wdc3iii/Pomdot/Reports/Pomdot_Poster_Expo.pdf

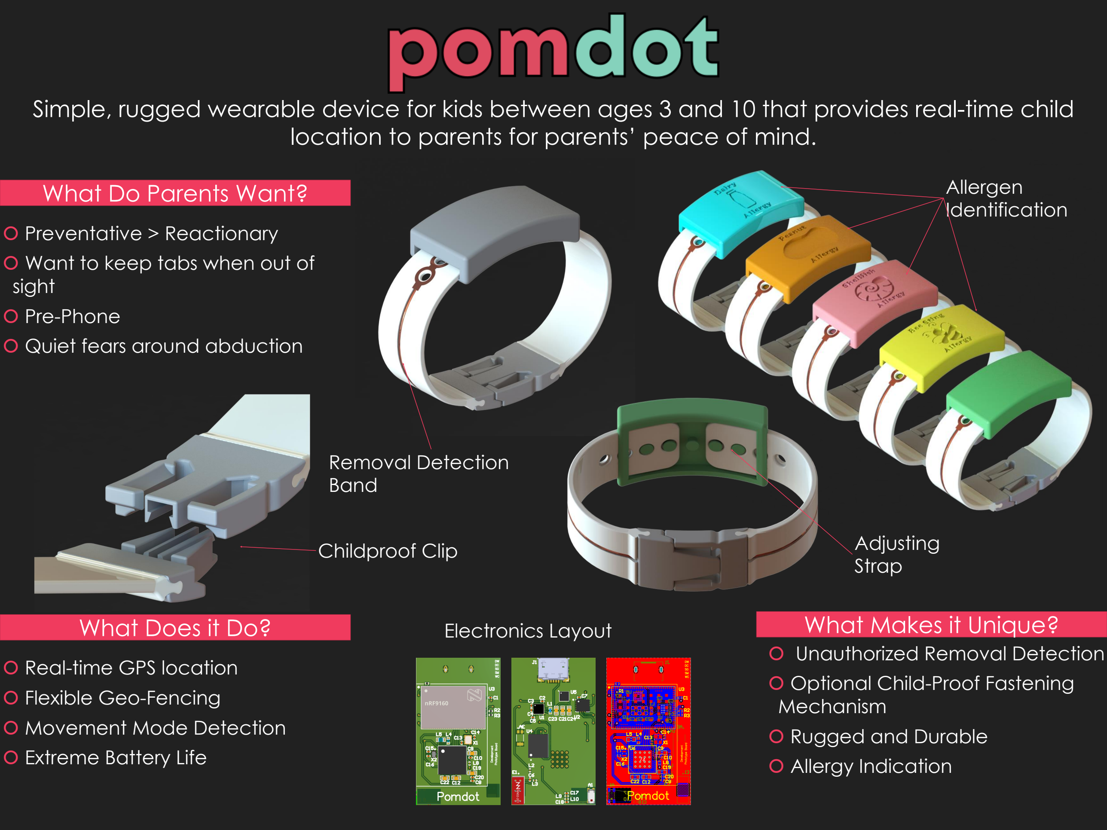
[picture p1: page 1]

Simple, rugged wearable device for kids between ages 3 and 10 that provides real-time child location to parents for parents’ peace of mind.

### What Do Parents Want?

- Preventative > Reactionary
- Want to keep tabs when out of sight
- Pre-Phone
- Quiet fears around abduction

### What Does it Do?

- Real-time GPS location
- Flexible Geo-Fencing
- Movement Mode Detection
- Extreme Battery Life

### What Makes it Unique?

- Unauthorized Removal Detection
- Optional Child-Proof Fastening Mechanism
- Rugged and Durable
- Allergy Indication

Childproof Clip

Allergen
Identification

Adjusting
Strap

Removal Detection
Band

Electronics Layout

Simple, rugged wearable device for kids between ages 3 and 10 that provides real-time child location to parents for parents’ peace of mind.

What Do Parents Want?

- Preventative >
Reactionary
- Want to keep tabs when
out of sight
- Pre-Phone
- Quiet fears around
abduction

What Does it Do?

- Real-time GPS location
- Flexible Geo-Fencing
- Movement Mode
Detection
- Extreme Battery Life

What Makes it Unique?

- Unauthorized Removal
Detection
- Optional Child-Proof
Fastening Mechanism
- Rugged and Durable
- Allergy Indication

Childproof
Clip

Allergen
Identification

Adjusting
Strap

Removal Detection
Band

Electronics Layout

### BLE Range: 400 feet

### Cellular Range: Global

### GPS Resolution: ~1m

### Battery Life: 175 hours

Outdoor
Range
(Line of
Sight)

260’

150’

Competitor’s

Ours
Specification

App Layout

400’

Indoor

(Wall
Penetration
– Industrial)

6 Walls

Indoor

(Multi-Floor–
Industrial)

3 Floors

7 Walls 4 Floors

Simple, rugged wearable device for kids between ages 3 and 10 that provides real-time child location to parents for parents’ peace of mind.

What Do Parents Want?

- Preventative >
Reactionary
- Want to keep tabs when
out of sight
- Pre-Phone
- Quiet fears around
abduction

What Does it Do?

- Real-time GPS location
- Flexible Geo-Fencing
- Movement Mode
Detection
- Extreme Battery Life

What Makes it Unique?

- Unauthorized Removal
Detection
- Optional Child-Proof
Fastening Mechanism
- Rugged and Durable
- Allergy Indication

Childproof
Clip

Allergen
Identification

Adjusting
Strap

Removal Detection
Band

Electronics Layout

### BLE Range: 400 feet

### Cellular Range: Global

### GPS Resolution: ~1m

### Battery Life: 175 hours

Outdoor

260’

150’

Competitor’s

Ours
Specification

App Layout

400’

Indoor

6 Walls

Indoor

3 Floors

7 Walls 4 Floors

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

What Do Parents Want?

- Preventative >
Reactionary
- Want to keep tabs when
out of sight
- Pre-Phone Monitoring
- Quiet fears around
abduction

What Does it Do?

- Real-time GPS location
- Flexible Geo-Fencing
- Movement Mode
Detection
- Extreme Battery Life

What Makes it Unique?

- Unauthorized Removal
Detection
- Optional Child-Proof
Fastening Mechanism
- Rugged and Durable
- Allergy Indication

Childproof
Clip

Allergen
Identification

Adjusting
Strap

Removal Detection
Band

Electronics Layout

### BLE Range: 400 feet

### Cellular Range: Global

### GPS Resolution: ~1m

### Battery Life: 175 hours

Outdoor

260’

150’

Competitor’s

Ours
Specification

App Layout

400’

Indoor

6 Walls

Indoor

3 Floors

7 Walls 4 Floors
