wdc3iii/Pomdot/Reports/Presentation 3.pdf

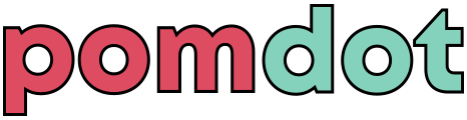
[picture p12: figure]

## What is it?

### Simple, rugged wearable device for kids between ages 3 and 10 that provides real-time child location to parents for parents’ peace of mind

## What Do Parents Want?

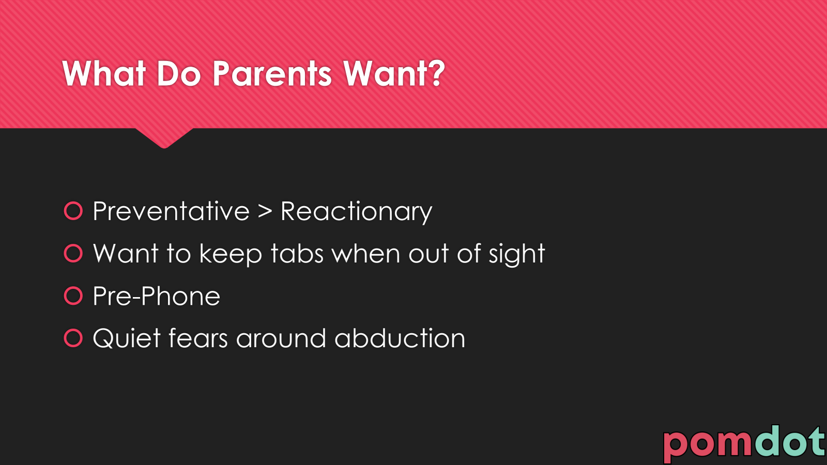
[picture p13: page 3]

- Preventative > Reactionary
- Want to keep tabs when out of sight
- Pre-Phone
- Quiet fears around abduction

## What does it do?

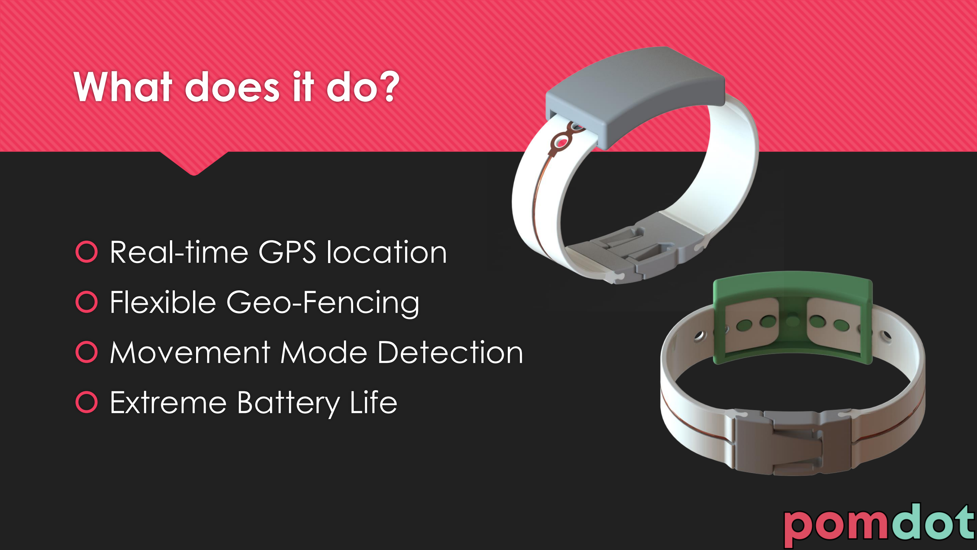
[picture p14: page 4]

- Real-time GPS location
- Flexible Geo-Fencing
- Movement Mode Detection
- Extreme Battery Life

## What makes it unique?

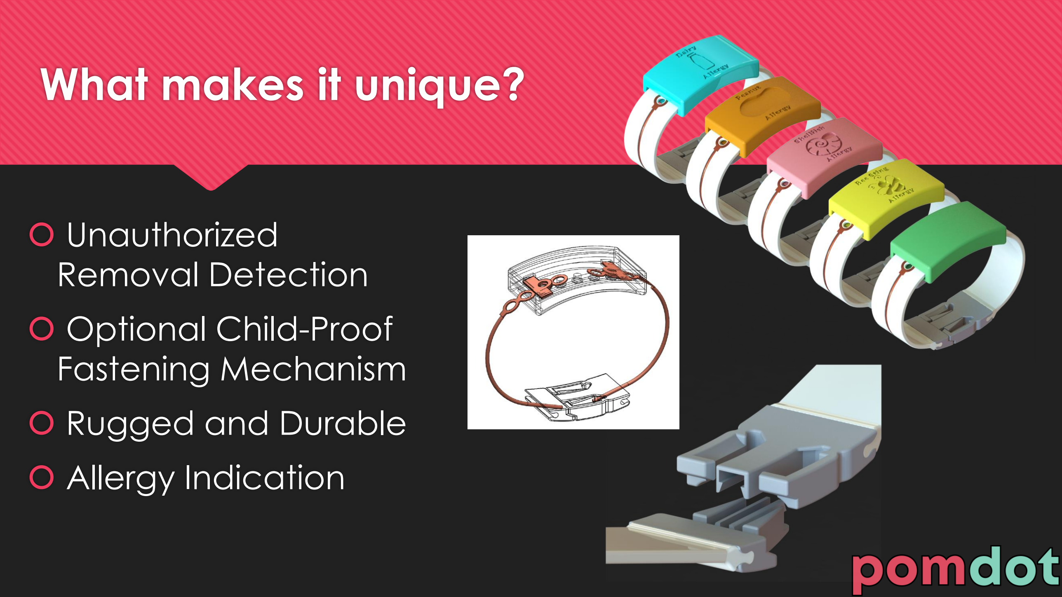
[picture p15: page 5]

- Unauthorized
Removal Detection
- Optional Child-Proof
Fastening Mechanism
- Rugged and Durable
- Allergy Indication

## Demo Time!

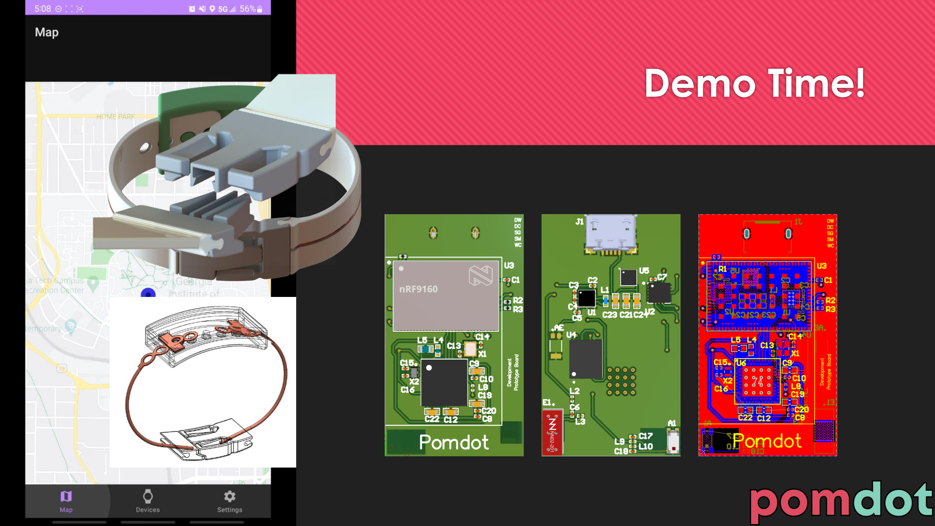
[picture p16: page 6]

## QUESTIONS?

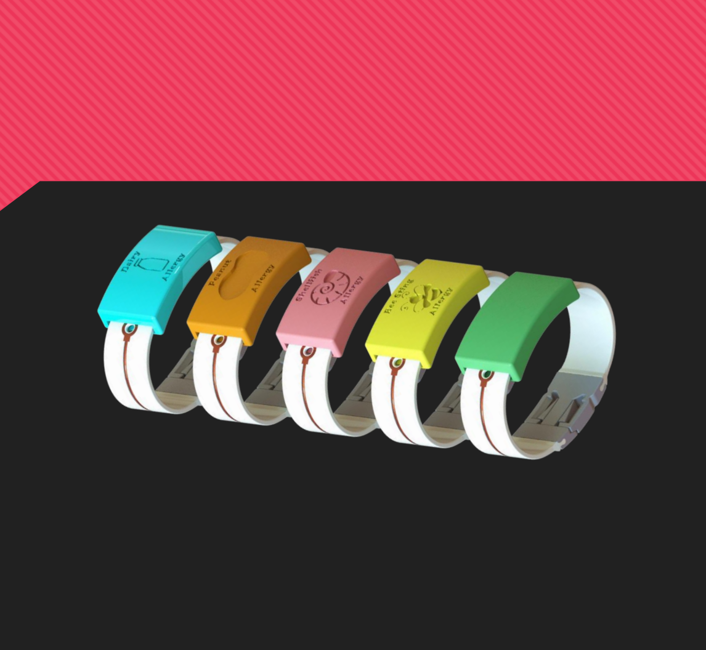
[picture p17: figure]
