wdc3iii/Pomdot/Reports/Presentation2.pdf

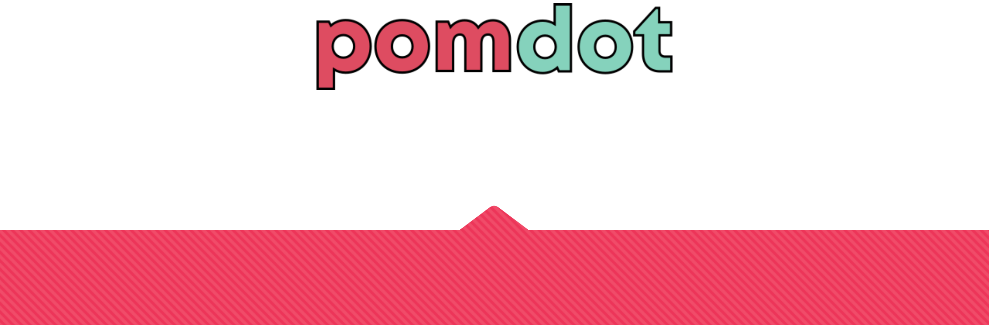
[picture p18: figure]

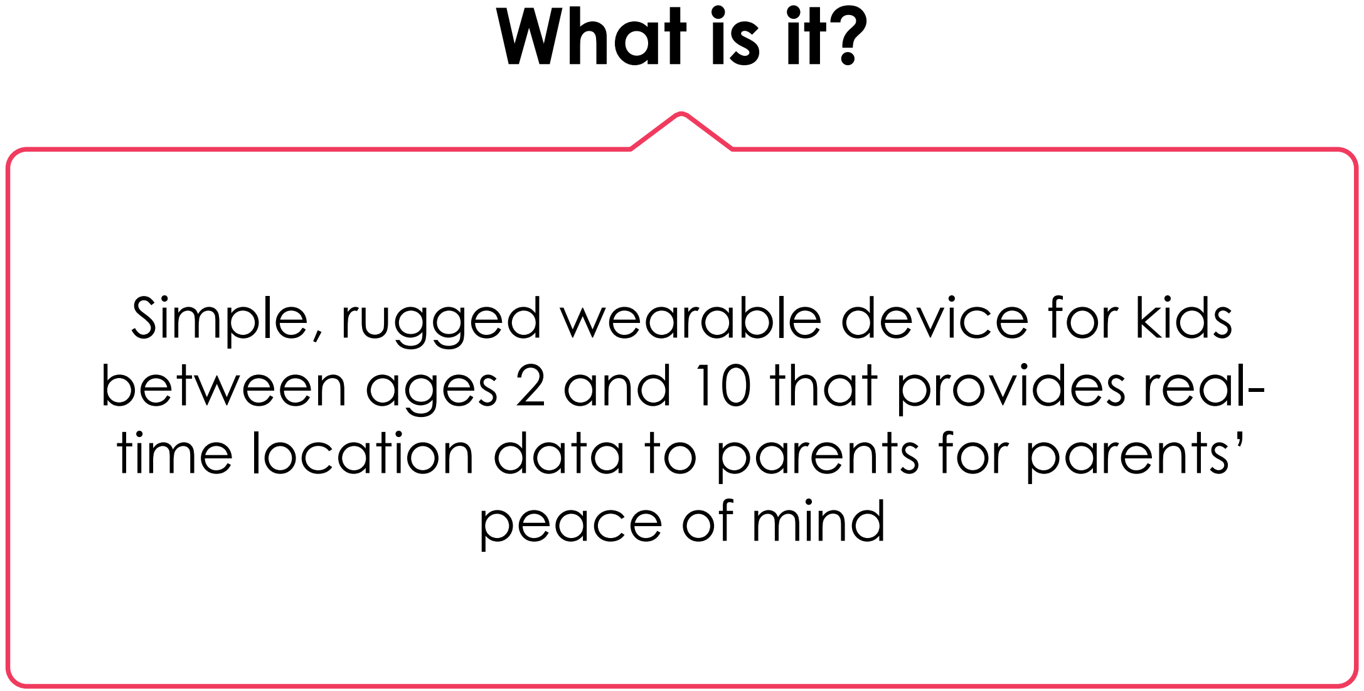
[picture p19: figure]
What is it?; Simple, rugged wearable device for kids; peace of mind

# between ages 2 and 10 that provides realtime location data to parents for parents’

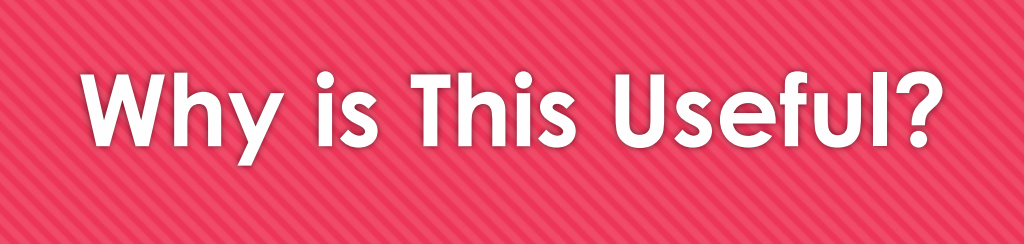
[picture p20: figure]
Why is This Useful?
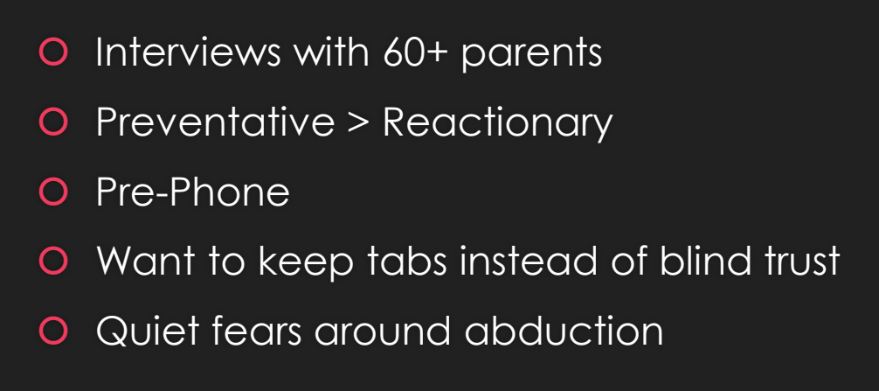
[picture p21: figure]
Interviews with 60+ parents; Preventative > Reactionary; Pre-Phone; Quiet fears around abduction

- Want to keep tabs instead of blind trust

# Existing Products

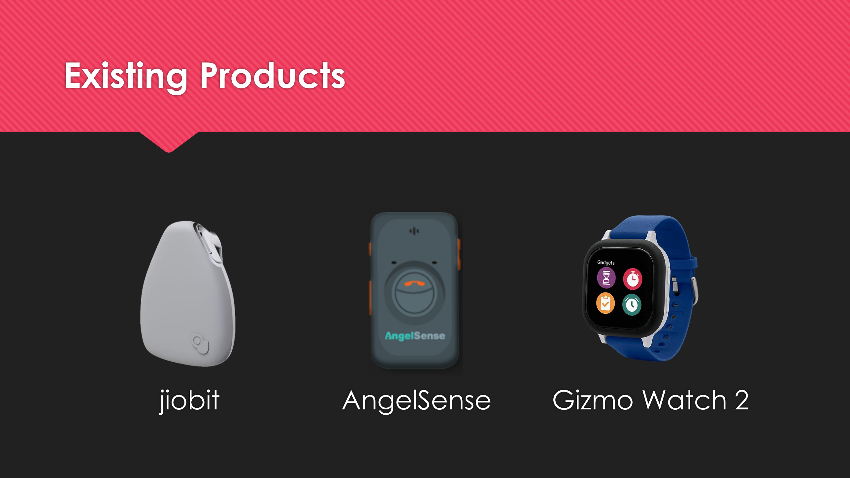
[picture p22: page 4]

jiobit | AngelSense | Gizmo Watch 2

# What Do Parents Want?

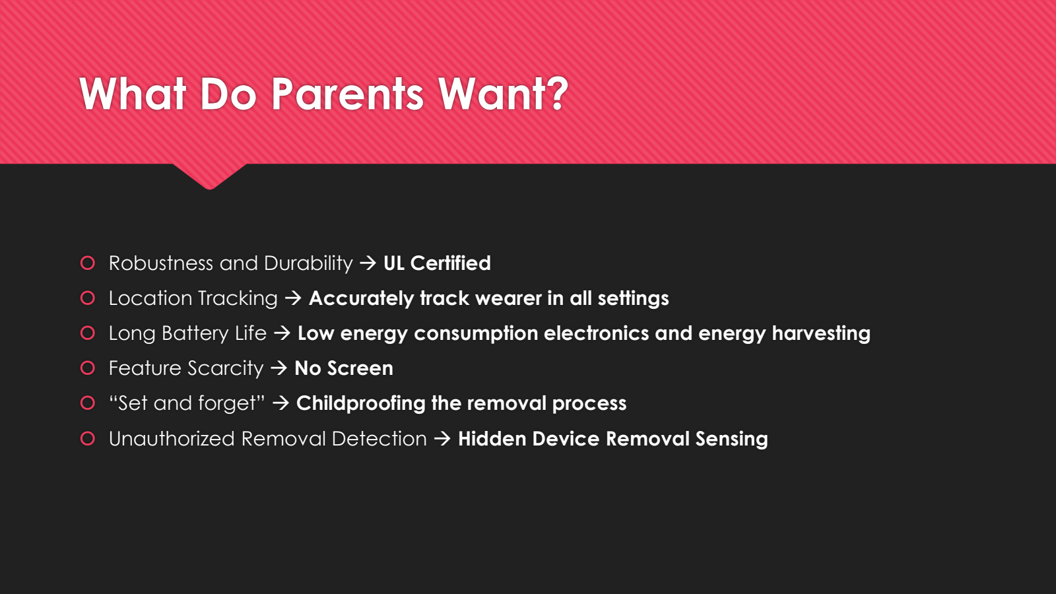
[picture p23: page 5]

- Robustness and Durability → UL Certified
- Location Tracking → Accurately track wearer in all settings
- Long Battery Life → Low energy consumption electronics and energy harvesting
- Feature Scarcity → No Screen
- “Set and forget” → Childproofing the removal process
- Unauthorized Removal Detection → Hidden Device Removal Sensing

# Lo-Fi Prototype

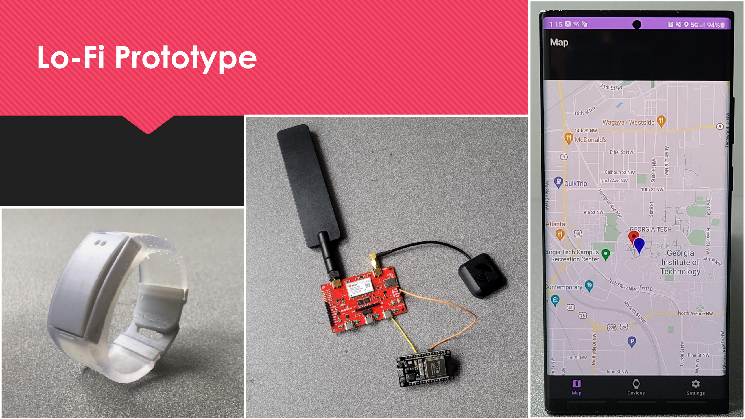
[picture p24: page 6]
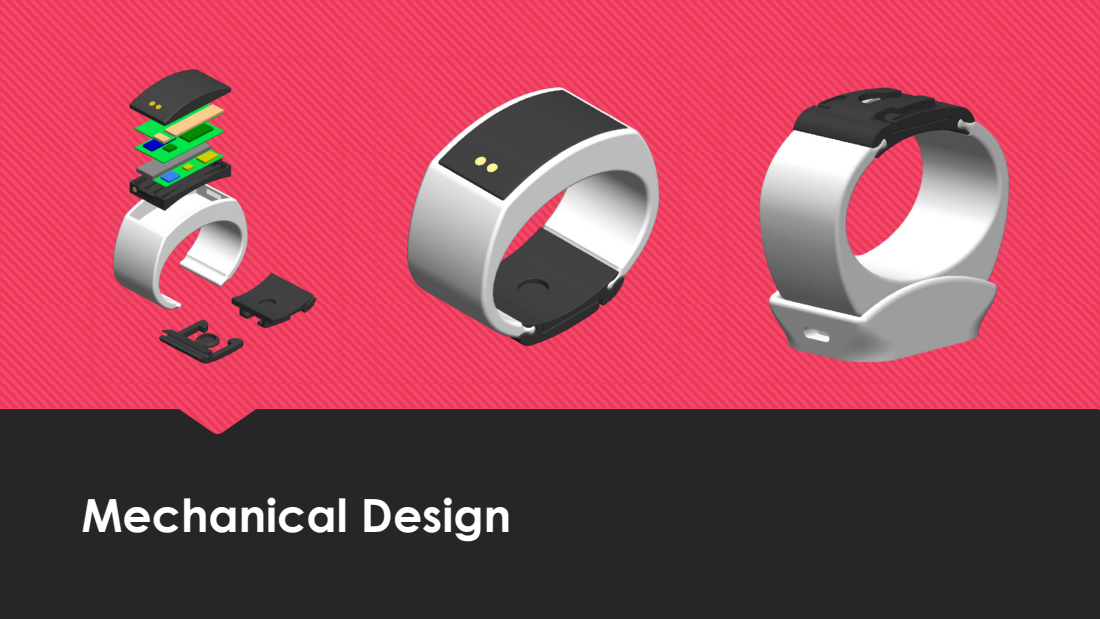
[picture p25: page 7]
Mechanical Design

# Electrical Design

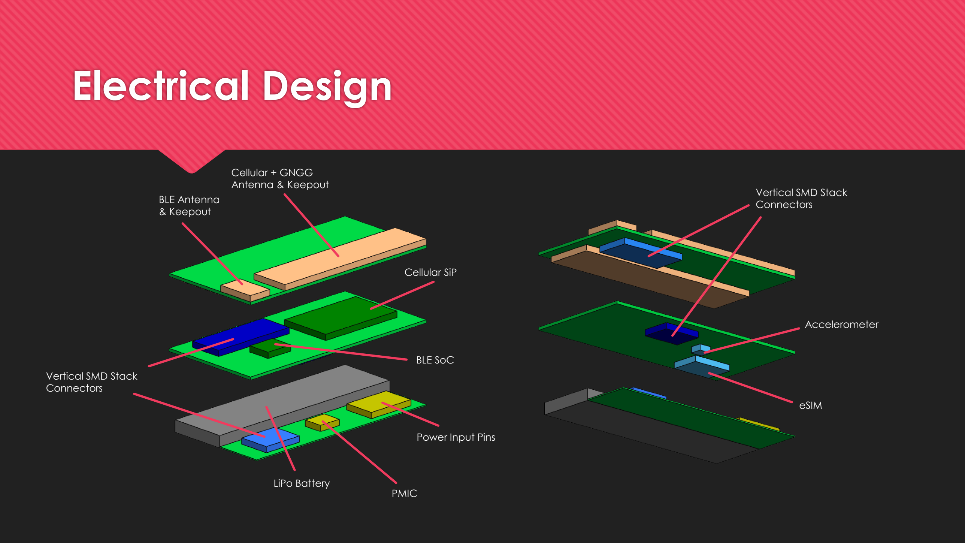
[picture p26: page 8]

Cellular + GNGG
Antenna & Keepout

Power Input Pins

Vertical SMD Stack
Connectors

Cellular SiP

BLE Antenna
& Keepout

LiPo Battery

BLE SoC

PMIC

Vertical SMD Stack
Connectors

eSIM

Accelerometer

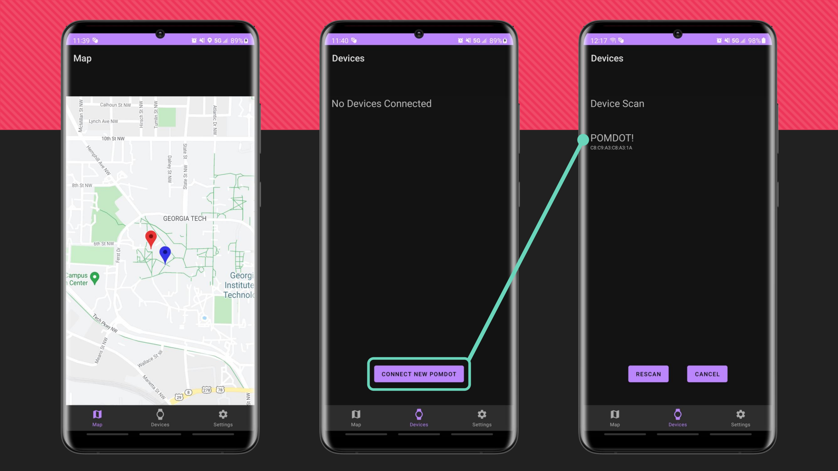
[picture p27: page 9]

# Benchmarking – Lo-Fi Prototype

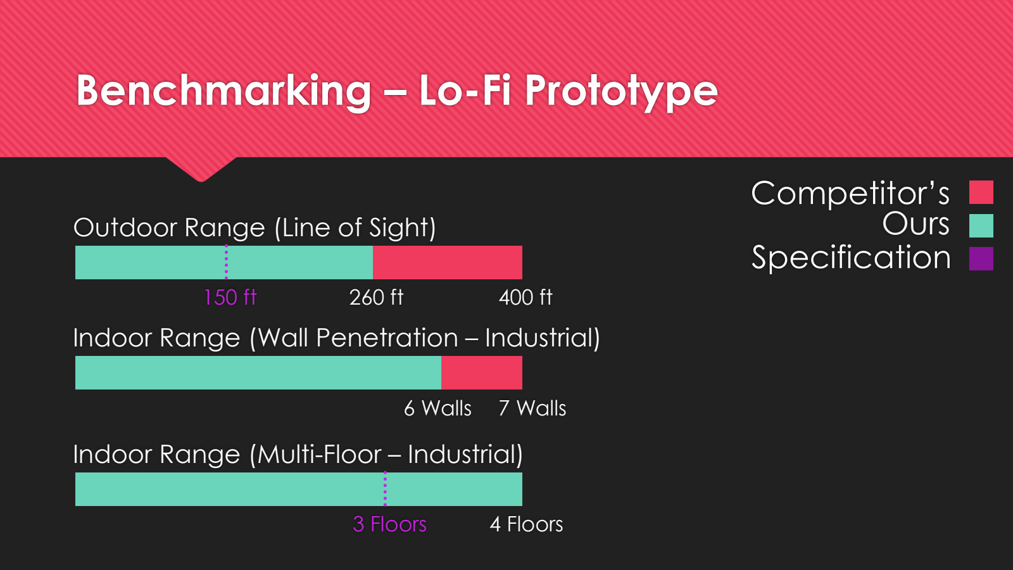
[picture p28: page 10]

# Competitor’s

Outdoor Range (Line of Sight) | Ours
260 ft | 400 ft

## Indoor Range (Wall Penetration – Industrial)

6 Walls 7 Walls

## Indoor Range (Multi-Floor – Industrial)

3 Floors | 4 Floors

150 ft

# Specification

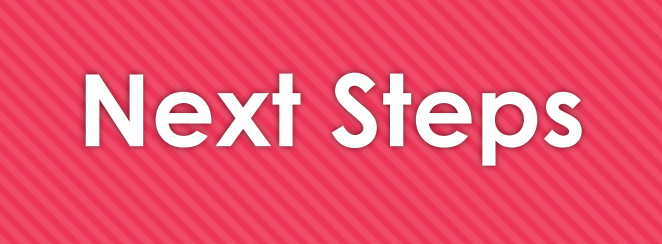
[picture p29: figure]
Next Steps
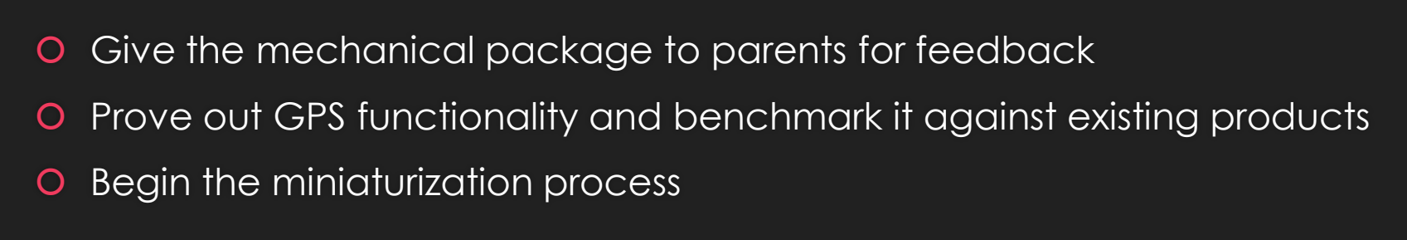
[picture p30: figure]
Begin the miniaturization process

- Give the mechanical package to parents for feedback
- Prove out GPS functionality and benchmark it against existing products

Local Wireless Communication Method | Bluetooth Bluetooth Low Nothing Energy Radar Classic
Global Wireless Communication Method | Cellular Low Frequency Satellite Nothing Radio

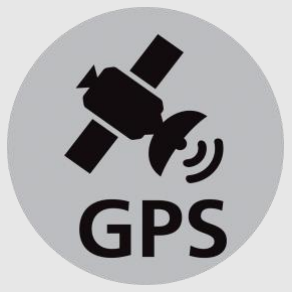
[picture p31: figure]

Positioning Protocol/Specificat ion | Bluetooth Low Ultra Wide-Nothing Band Energy

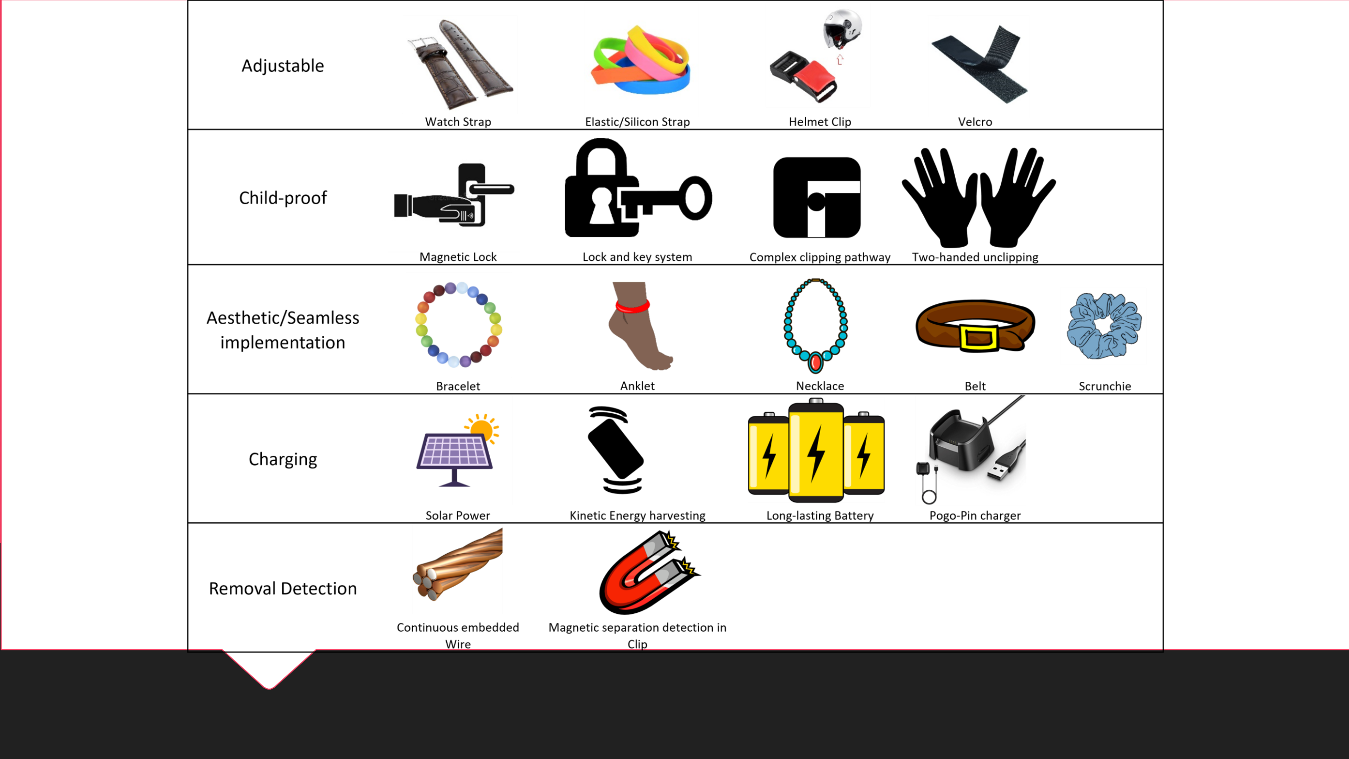
[picture p32: page 14]
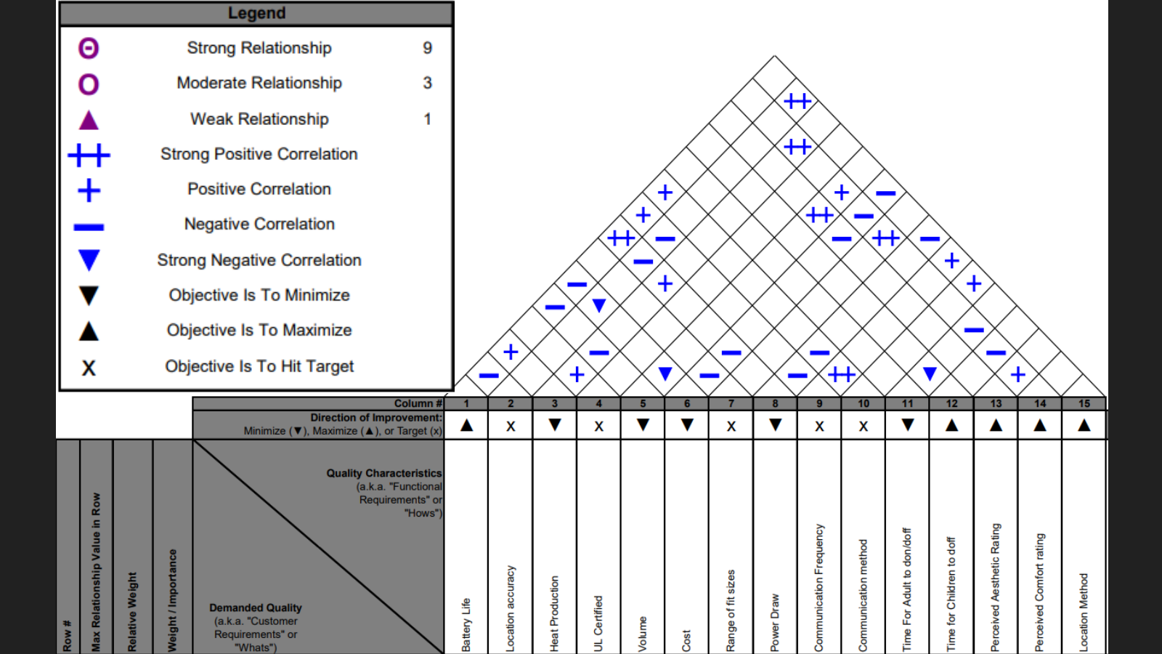
[picture p33: page 15]
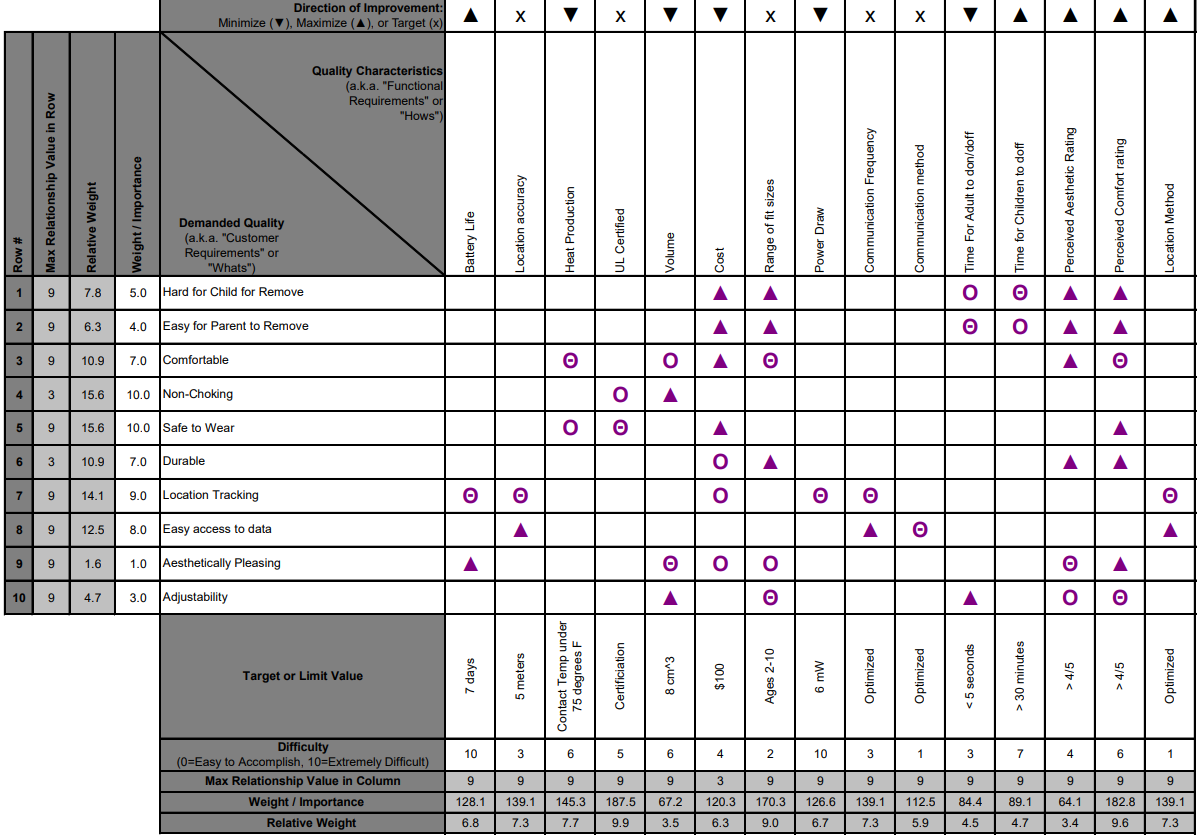
[picture p34: page 16]
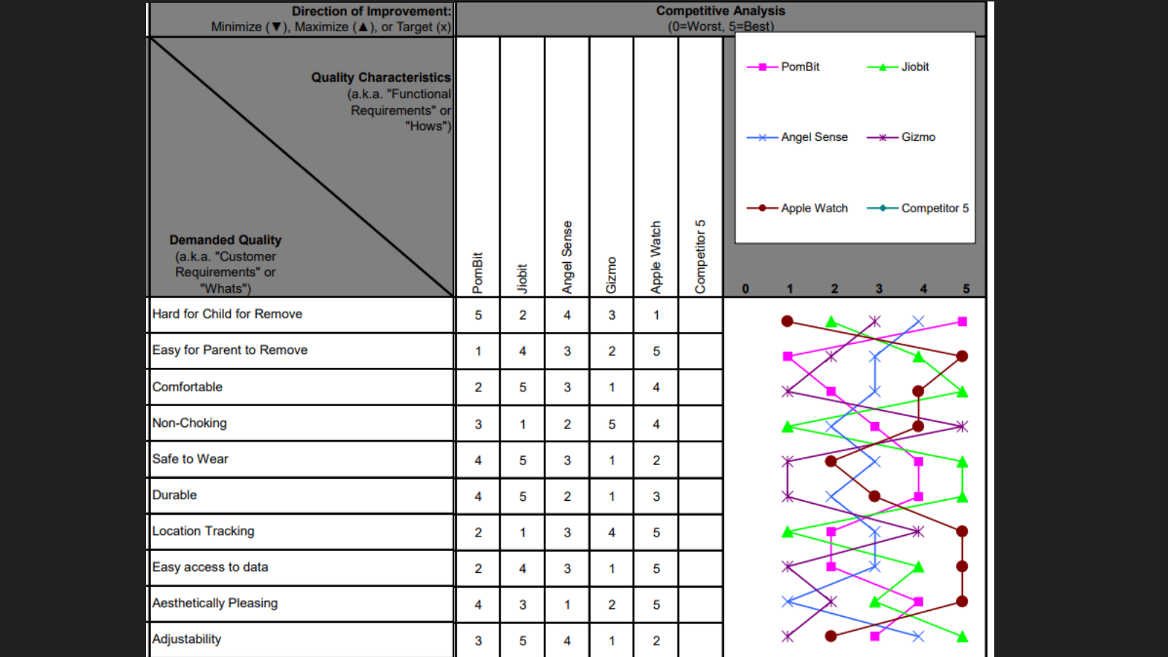
[picture p35: page 17]
