wdc3iii/Pomdot/Pomdot Medium Fidelity Electronics Prototype/BLE_Header.h

#define BLE_GATT_SERVER_NAME "POMDOT!"

#define DETACHED_CHAR_UUID      "1eabbc68-2870-49d0-9bc6-417902b2e2d5"
#define DETACHED_DESC_UUID      0x2902
#define DETACHED_SERV_UUID      "211d75bd-1d8b-4897-bdcf-ecff7a7f896e"
#define DetachedService         DETACHED_SERV_UUID

#define POMDOT_CHAR_UUID        0x2ABE
#define POMDOT_DESC_UUID        0x2902
#define POMDOT_SERV_UUID        "7b4bffd6-1b31-4af5-9ef5-afa2972ced14"
#define POMDOTService           POMDOT_SERV_UUID

#define LOCATION_LAT_CHAR_UUID  "71dc81c7-c2a5-4296-bf47-83490b51e9f8"
#define LOCATION_LAT_DESC_UUID  0x2902
#define LOCATION_LON_CHAR_UUID  "e5b7f683-d622-499d-93e8-60f0969f94a6"
#define LOCATION_LON_DESC_UUID  0x2902
#define LOCATION_SERV_UUID      "74b93a57-aa7b-4b7e-93d7-ea5f58b19364"
#define TIME_CHAR_UUID          "1f418979-4776-440a-b0ff-57af57594086"
#define TIME_DESC_UUID          0x2902
#define DATE_CHAR_UUID          "b9152bc4-31af-4012-8f22-0cd93299ab3a"
#define DATE_DESC_UUID          0x2902
#define LocationService         LOCATION_SERV_UUID
